LasDesu/Aleste-520EX/README.md

# aleste520ex
Project to recreate home computer Aleste 520EX
