LasDesu/Aleste-520EX/doc/manual.txt

                            ВВЕДЕНИЕ
      Поздравляем  Вас  с  покупкой  персонального  компьютера
" ALESTE 520  EX ".   Эта   модель   компьютера   совместима  по
програмному    обеспечению   и   переферийному   оборудованию  с
компьютером  " AMSTRAD CPC 6128 ".
        Ниже  приведены  особенности  компьютера  этой   модели.
     - Англо / Русская клавиатура.
     - Энергонезависимое ЗУ с часами.
     - Возможность работы в CP/M или MSX-DOS.
     - Встроенный BASIC.
     - ОЗУ компьютера расширено до 512К.
     - Компьютер  поддерживает  5  графических  режимов  экрана.
     - В  качестве   монитора   возможно   применение   бытового
       телевизора.
     - Имеется возможность для подключения  принтера, джойстика,
       любого  устройства с интерфейсом RS-232 ( "мышь" и др. ).
        Данное  руководство  представляет необходимую информацию
для  правильного  включения  и эксплуатации компьютера.  Поэтому
внимательно прочтите это руководство перед вводом в эксплуатацию
компьютера  и  сохраните  его  в  надежном  месте,   так как оно
одновременно является паспортом Вашего компьютера.

            ТЕХНИЧЕСКИЕ ХАРАКТЕРИСТИКИ
 
Центральный процессор____________________________Z80A
Тактовая частота________________________________4 МГц
Память
      ОЗУ_____________________________________512 К
        ПЗУ______________________________________64 К
Клавиатура_____________________встроенная (78 клавиш)
                Графические режимы.
   160x200 16 цветов каждая точка из палитры 64 цвета
   20 знаков в строке, 25 строк
 
   320x200  4 цвета  каждая точка из палитры 64 цвета
   40 знаков в строке, 25 строк
 
   640x200 монохром  каждая точка из палитры 64 цвета
   80 знаков в строке, 25 строк
 
   320x200 16 цветов каждая точка из палитры 64 цвета
   40 знаков в строке, 25 строк
 
   640x200  4 цвета  каждая точка из палитры 64 цвета
   80 знаков в строке, 25 строк
 
В режиме AMSTRAD количество цветов в палитре уменьшается
до 27.   Два последних режима имеются только в  MSX-DOS.
 
Звук____________________________ стерео сопровождение
Часы с календарем___________________энергонезависимые
Внешнее запоминающее устройство______________Дисковод
      Колличество__________________________до 2 шт.
        Емкость
                MSX-DOS__________________________720К
                AMSTRAD BASIC____________________180К
        Тип______________________________5'25 или 3'5
Периферийные устройства
  - Джойстик
  - Принтер (последовательный или паралельный)
  - "Мышь" или любое устройство с интерфейсом RS-232
  - Усилитель (музыкальное сопровождение)
  - Др. устройства через системный разъем  (например,
    плату MAGIG SOUND - музыкальный синтезатор)
Общие данные
      Напряжение питания__________________220В 50Гц
        Размеры
        Основной блок_______________430х250х50 мм.мм.
        Блок питания________________80х190х120 мм.мм.
        Масса
        Основной блок__________________________1,5 кг
        Блок питания___________________________1,5 кг

                   КОМПЛЕКТАЦИЯ
Системный блок_________________________________1 шт.
Блок питания с дисководом______________________1 шт.
Диски__________________________________________5 шт.
Паспорт________________________________________1 шт.
Джойстик_______________________________________1 шт.
Кабель подключения к монитору__________________1 шт.

ВНИМАНИЕ! В компьютере может быть не установлена батарея
энергонезависимых часов.
 
                         МЕРЫ ПРЕДОСТАРОЖНОСТИ
     Хотя рассматриваемый компьютер сконструирован прочно, он не
должен подвергаться экстремальным условиям. Мы  рекомендуем  Вам
соблюдать  следующие  меры  предосторожности  для  того,   чтобы
обеспечить его долговечность.
     - Избегайте падений компьютера и ударов по нему.
     - Не  подвергайте  компьютер  действию  прямого  солнечного
       света  или  других  источников   тепла;   не   закрывайте
       вентиляционные отверстия.
     - Не проливайте жидкости; если жидкость пролита на основную
       плату или клавиатуру,  то немедленно выключите компьютер.
     - Избегайте  влажности и пыли  в  помещении,  где находится
       компьютер.
     - Не ставьте тяжелые предметы на клавиатуру.
     - Протирайте компьютер мягкой, чистой тканью, не применяйте
       растворителей или очистителей.

               ВВОД КОМПЬЮТЕРА В ЭКСПЛУАТАЦИЮ
     Распакуйте компоненты:
     - Компьютер
     - Блок питания с дисководом
     - Шнур для подключения монитора
     - Дискеты
ВНИМАНИЕ!   ПОДСОЕДИНЕНИЕ ВСЕХ РАЗъЕМОВ ОСУЩЕСТВЛЯЙТЕ ТОЛЬКО ПРИ
ОТКЛЮЧЕННОМ КОМПЬЮТЕРЕ.
 
                     СХЕМА ПОДКЛЮЧЕНИЯ
    Монитор
 ┌─────────┬──┐            Принтер         Дисковод с БП
 │         │оо│  Джойстик ┌────────┐           ┌─┬─┐
 │         │  │    ┌┐    ┌│╝╝╝╝╝╝╝╝│┐          │││о│
 │         │  │   ┌┼┼┐  ┌┤└────────┘├┐         │╕│ │
 │         │  │  ┌┴──┴┐ └──│─────────┘ ┌────────││ ──────┐
 └─────────┴│─┘  └│───┘    │      ┌────┘       └─┴─┘     │
    ┌───────┘     │        │      │   Усилитель     Мышь │
    │   ┌─────────┘        │      │ ┌────────────┐  ┌╦╦┐ │
    │   │   ┌──────────────┘      │ │   о о  О  о│  │  │ │
    │   │   │                     │ └─────────│──┘  └─│┘ │
    │   │   ├───┐      системный  └─────────┐ └────┐  │  │
   ┌┴┐ ┌┴┐ ┌┴┐ ┌┴┐  ┌── разъем ───┐       ┌─┴───┐ ┌┴┐┌┴┐┌┤
 ┌─┴1┴─┴2┴─┴3┴─┴4┴──────── 5 ─────────────── 6 ───┴7┴┴8┴┴9┐
 │                                                        │
 │                                                        │
 │                      К О М П Ь Ю Т Е Р                 │
 │                                                        │
 │                                                        │
 └────────────────────────────────────────────────────────┘
    1  -  разъем для подключения монитора
    2  -  разъем для подключения джойстика
    3  -  разъем 1 для подключения принтера
    4  -  разъем 2 для подключения принтера
    5  -  системный разъем
    6  -  разъем для подключения дисководов
    7  -  разъем для подключения усилителя
          ( для звукового сопровождения программ )
    8  -  разъем интерфейса RS-232 (подключается мышь или другие
          устройства с этим интерфейсом)
    9  -  шнур для подключения питания

                         ЗАПУСК КОМПЬЮТЕРА
 
     ПРИ ПЕРВОМ ВКЛЮЧЕНИИ КОМПЬЮТЕРА РЕКОМЕНДУЕМ ВАМ  ПРОИЗВЕСТИ
СЛЕДУЮЩИЕ ДЕЙСТВИЯ:
     -  УСТАНОВИТЬ  КОНФИГУРАЦИЮ  КОМПЬЮТЕРА  СОГЛАСНО   РАЗДЕЛУ
" КОНФИГУРАЦИЯ КОМПЬЮТЕРА ".
     - ЗАГРУЗИТЬ ОПЕРАЦИОННУЮ СИСТЕМУ СОГЛАСНО РАЗДЕЛУ  " ЗАПУСК
MSX-DOS ".
     - СДЕЛАТЬ КОПИИ СИСТЕМНЫХ ДИСКЕТ И РАБОТАТЬ В ДАЛЬНЕЙШЕМ  С
КОПИЯМИ (см. руководство к MSX-DOS).
  
     1)  Убедитесь,  что  компьютер  и  периферийные  устройства
подключены  к  электросети.
     2) Включать компьютерную  систему  необходимо  в  следующем
порядке:
        Монитор -- Периферийные устойства -- Компьютер
Выключать в обратном порядке.
     После включения питания на экране  появится  заставка  и  в
нижней части экрана сообщение:
                   BOOT ERROR. PRESS ANY KEY
     Сообщение BOOT  ERROR.  PRESS  ANY  KEY  (Ошибка  загрузки.
Нажмите любую клавишу), показывает Вам, что  компьютер попытался
загрузить операционную систему, но не нашел ее.
     В ответ на это сообщение  Вы  можете  произвести  следующие
действия:
     1) Вставить в  дисковод  диск  с  операционной  системой  и
нажать любую клавишу. Далее смотри раздел РАБОТА В MSX-DOS.
     2) Выйти в BASIC (см. раздел ЗАПУСК BASICа).
                          ПРИМЕЧАНИЕ
     - Если в момент включения в дисководе уже  была  дискета  с
операционной  системой,  то  система  загрузится  автоматически.
Сообщение BOOT ERROR. PRESS ANY KEY не выводится.
     - Для работы с BASIC  Вы  можете  нажать  клавишу  SHIFT  и
включить компьютер.  В этом случае заставка не будет выведена на
экран.  Она появится  когда Вы  первый раз попытаетесь загрузить
операционную систему командой  │MSX  или перезагрузите компьютер
без удержания клавиши SHIFT.

                      КОНФИГУРАЦИЯ КОМПЬЮТЕРА
 
     После включения в энергонезависимой памяти  устанавливается
конфигурация компьютера, т.е параметры определяющие,  как  будет
работать компьютер после включения.
     Для  просмотра  установленной конфигурации или ее изменения
необходимо   произвести  перезагрузку  компьютера  с  удержанием
клавиши  СТР,  т.е.  нажать  клавишу  СТР и  удерживая ее нажать
клавишу RES.
     После этого на экране появиться следующая таблица.
    
                      ALESTE 520EX  SETUP
       ┌──────────────────────────────────────────────┐
       │ Language                             English │
       │ Current date                      14/10/1993 │
       │ Current time                         0:00:04 │
       │ Boot drive                                А: │
       │ RAM disk                                 Off │
       │ Display type                           Color │
       │ Screen mode                        640x200x2 │
       │ Screen color    Text             Back        │
       │ Keyboard rate   Delay  08        Repeat   02 │
       │ Keyboard click                            On │
       │ Beep            Tone    0        Volume   08 │
       │ Mouse                                    Off │
       │ Print interface                     Parallel │
       │ Print coding                           KOI-8 │
       │ Serial port   RTS/CTS       Baud rate   1200 │
       │ Bits  8      Parity   Off      Stop bits   1 │
       ├──────────────────────────────────────────────┤
       │ ESC - Quit                                   │
       │ F1  - Save settings  and quit                │
       │ F5  - Run diagnostics                        │
       │           - Move cursor                      │
       │ SHIFT+   or SPASE - Charge field             │
       └──────────────────────────────────────────────┘
Если  Вы  хотите читать текст в таблице по русски - не перемещая
курсор нажмите клавишу пробел.
 
     При  первом  включении  Вам  необходимо  в  первую  очередь
установить точные ДАТУ и ВРЕМЯ.
 
                           Внимание!
     - Если при  включении  устанавливается  дата  14/10/1993  в
компьютере отсутствует батарейка или она неисправна.
     -  Если  в  компьютере  не  установлены  элементы  питания,
установленная конфигурация не будет запоминаться при  выключении
компьютера.  Поэтому  при последующем включении компьютера будет
восстанавливаться стандартная конфигурация, показанная в таблице.
     - Функция  Run diagnostics работает не на всех компьютерах.

                   ЗАПУСК BASIC-AMSTRAD
     Для выхода в режим BASIC-AMSTRAD необходимо нажать  клавишу
SCHIFT и удерживая ее нажать клавишу RESET. По сбросу на  экране
появиться следующие сообщения.
 
 ┌───────────────────────────────────────────┐
 │   Aleste 520EX Personal Computer          │
 │   @1985 Amstrad Consumer Electronics plc  │
 │             and Locomotive Software Ltd.  │
 │   Basic 1.1                               │
 │  Ready                                    │
 │  █                                        │
 │                                           │
 └───────────────────────────────────────────┘
 
Сообщение  Ready и курсор под ним показывает  Вам  что компьютер
готова к работе.
Некоторые команды работы с диском:
     CAT - Просмотра каталога.
     RUN"имя программы" - запуск программы.
     │CPM - запуск программ с защитой.
     Например: RUN"Exolon" <RETURN>.
Символ "│" вводится нажатием клавиши @ при нажатой клавише SHIFT.
 
ПРИМЕЧАНИЕ:  Форматы  дисков  операционной  системы  MSX-DOS   и
BASIC несовместимы.   Это oзначaeт что нельзя работать в BASIC с
дисками отформатированными в MSX-DOS и наоборот.  Если Вы хотите
сохранить  свою  программу  на  BASIC  на  диске Вам нужно будет
отформатировать  его   специальной   программой.    На  диске  с
системными программами MSX-DOS имеется такая программа (AMC.COM).

                         ЗАПУСК MSX-DOS
     Загрузить операционную систему можно  в  нескольких режимах
работы: ПК  ALESTE  520  EX  имеет  следующие  режимы  работы  в
операционной  системе  MSX-DOS,  которые   устанавливаются   при
инициализации.
     -  СТАНДАРТНЫЙ  РЕЖИМ  -  устанавливается   по   умолчанию.
Поддерживается работа с дисководами  A:  и  B:  (при  отсутствии
дисковода  B:   поддерживаются   логические   диски   на   одном
дисководе), конфигурация электронного диска  читается  из  часов
реального времени.  При  наличии  на  электронном  диске  файлов
операционной сиситемы с него производится начальная загрузка,  в
противном   случае   загрузка    производится    с    дисковода,
определенного в SETUP.
     - РЕЖИМ ОДНОГО ДИСКОВОДА - включается при удержании клавиши
CTRL после  сброса.  В  этом  режиме  используется  только  один
физический дисковод A: (независимо от наличия второго). При этом
несколько  увеличивается  объем  памяти,  доступной   программам
пользователя. Инициализация электронного диска и логика загрузки
ОС не отличается от стандартного режима.
     - РЕЖИМ ЗАГРУЗКИ С ДИСКОВОДА  -  включается  при  удержании
клавиши   ALT   после   сброса.   Режим   полностью   аналогичен
стандартному, за исключением того, что загрузка ОС  производится
с диска, определенного  в  SETUP.  Режим  полезен  для  спасения
файлов с электронного диска в случае, если загрузка  с  него  по
каким-либо причинам не производится.
     - РЕЖИМ  АВАРИЙНОЙ  ЗАГРУЗКИ  -  включается  при  удержании
клавиши ESC после сброса и используется в  случае  неисправности
часов реального  времени.  При  этом  загрузка  ОС  производится
всегда с дисковода A: и электронный диск не инициализируется.
     ПРИМЕЧАНИЕ:  Удержание  клавиши  ESC   приводит   также   к
включению режима авариной загрузки в BIOS и ПЗУ загрузчика.
     - РЕЖИМ АВАРИЙНОЙ ЗАГРУЗКИ  С  ИНИЦИАЛИЗАЦИЕЙ  ЭЛЕКТРОННОГО
ДИСКА - включается  при  удержании  комбинации  клавиш  ALT+ESC.
Отличается от предыдущего тем, что инициализируется  электронный
диск емкостью 256K независимо от установок в SETUP.
     При   необходимости   допускается   совместное    включение
нескольких режимов.
ВНИМАНИЕ! Если операционная система не загружается,  попытайтесь
загрузить ее, удерживая клавишу ESC.
 
     Для выхода в режим MSX-DOS необходимо:
     - вставить дискету с системой MSX-DOS в дисковод
     - в зависимости  от  выбраного  Вам  режима  работы  нажать
необходимую комбинацию клавиш и перезагрузить компьютер.
   После  загрузки  системы  на   экране   появиться   следующие
сообщения.
 
 ┌───────────────────────────────────────────┐
 │                                           │
 │   ALESTE 520EX BIOS version 1.01          │
 │   (c) 1993 PATISONIC                      │
 │                                           │
 │   MSX-DOS version 1.04                    │
 │   Copyright 1984 by Microsoft             │
 │                                           │
 │   Command version 2.2A                    │
 │   (c) 1993 Patisonic                      │
 │   Date is                                 │
 │                                           │
 │   a>_                                     │
 │                                           │
 └───────────────────────────────────────────┘
 
     Сообщение "a>" показывает о готовности системы к выполнению
Ваших команд.
     Операционную  систему  можно загрузить и из  AMSTRAD BASIC.
Для этого  после  выхода в  AMSTRAD BASIC  необходимо  выполнить
команду: │MSX <RETURN>.
 
     Некоторые команды работы с диском:
     DIR - Просмотра каталога.
     "имя программы" - загрузка программы.
     Например: a> PW <RETURN> - запускается текстовый редактор.
 
     Описание  системных  программ,  поставляемых  на диске,  Вы
можете приобрести в фирме PATISONIC.

                      НЕСИМВОЛЬНЫЕ КЛАВИШИ
 
                           BASIC
     ESC          Выполняет функцию прерывания программы.
 
     TAB          Переводит курсор вправо на позицию кратную  8.
 
     CTRL         В  сочетании  с  другими клавишами задает коды
                  управления или выводит символы  псевдографики.
 
     SHIFT        Эта  клавиша  нажимается одновременно с любыми
                  клавишами для получения большой буквы, а также
                  для    премещения    второго    курсора    при
                  редактировании.
 
    F1-F10        Функциональные    клавиши.     Это     клавиши
                  программируемых  функций.   Они действуют  так
                  как будут определены пользователем.
 
    DEL           Клавиша  удаления.   При нажатии этой клавиши,
                  символ стоящий, справа от курсора   удаляется,
                  а   все   остальные   символы   этой    строки
                  сдвигаются  влево  на  одну  позицию.
 
    BS            После нажатия этой клавиши удаляется 1  символ
                  слева  от  курсора,  курсор  и  все  остальные
                  символы строки сдвигаются влево.
 
    COPY          Позволяет  осуществлять  копирование.  Границы
                  копирования    задаются   с   помощью   клавиш
                  управления курсором ( см. описание BASIC ).
 
                  Курсор передвигается в направлении,  указанном
                  на  клавише.
 
    RETURN        При нажатии этой клавиши курсор  передвигается
                  в первую  позицию  следующей  строки  и  BASIC
                  начинает выполнение набранной команды.
 
    ENTER         Действует   аналогично   RETURN,    но   можно
                  перепрограммировать как функциональную клавишу.

                           MSX - DOS
     ESC          Используется в прикладных программах.
 
     TAB          Переводит курсор вправо на позицию кратную 8.
 
     CTRL         В  сочетании  с  другими клавишами задает коды
                  управления или выводит символы  псевдографики.
 
     SHIFT        Эта  клавиша  нажимается одновременно с любыми
                  клавишами для смены регистра.
 
     F1-F10       Используются в прикладных программах.
 
     DEL          Клавиша удаления символа.
 
     BS           После нажатия этой клавиши удаляется 1  символ
                  слева  от  курсора,  курсор  и  все  остальные
                  символы строки сдвигаются влево.
 
     HELP         Используется в прикладных программах.
 
     INS          Клавиша вставки.
 
     ALT          Используется в прикладных программах.
 
                  Курсор передвигается в направлении,  указанnом
                  на клавише.
 
     RETURN       При нажатии этой клавиши курсор  передвигается
                  в первую позицию следующей  строки  и  система
                  начинает выполнение набранной команды.
 
     ENTER        Действует аналогично RETURN.

                         СИМВОЛЬНЫЕ КЛАВИШИ
 
                                BASIC
                         НОРМАЛЬНЫЙ РЕЖИМ
┌─────┬─────┬─────┬─────┬─────┐               ┌─────┬─────┬─────┐    ┌─────┬─────┐
│     │     │     │     │     │               │     │     │ DEL │    │     │ RES │
└─────┴─────┴─────┴─────┴─────┘               └─────┴─────┴─────┘    └─────┴─────┘
┌─────┬───┬───┬───┬───┬───┬───┬───┬───┬───┬───┬───┬───┬───┬─────┐    ┌───┬───┬───┐
│ ESC │ ; │ 1 │ 2 │ 3 │ 4 │ 5 │ 6 │ 7 │ 8 │ 9 │ 0 │ - │   │  BS │    │   │   │   │
├─────┴─┬─┴─┬─┴─┬─┴─┬─┴─┬─┴─┬─┴─┬─┴─┬─┴─┬─┴─┬─┴─┬─┴─┬─┴─┬─┴─┬───┤    ├───┼───┼───┤
│  TAB  │ j │ c │ u │ k │ e │ n │ g │ { │ } │ z │ h │ : │ / │   │    │ F7│ F8│ F9│
├───────┴┬──┴┬──┴┬──┴┬──┴┬──┴┬──┴┬──┴┬──┴┬──┴┬──┴┬──┴┬──┴┬──┘   │    ├───┼───┼───┤
│  CTRL  │ f │ y │ w │ a │ p │ r │ o │ l │ d │ v │ \ │ . │RETURN│    │ F4│ F5│ F6│
├────┬───┴─┬─┴─┬─┴─┬─┴─┬─┴─┬─┴─┬─┴─┬─┴─┬─┴─┬─┴─┬─┴──┬┴──┬┴──┬───┤    ├───┼───┼───┤
│CAPS│SPARE│ q │ | │ s │ m │ i │ t │ x │ b │ @ │ '  │   │   │   │    │ F1│ F2│ F3│
├────┴───┬─┴───┼───┴───┴───┴───┴───┴───┴───┴┬──┴────┤   ├───┤   │    ├───┼───┼───┤
│  SHIFT │ COPY│         SPACE              │ SHIFT │   │   │   │    │ F0│ . │ENT│
└────────┴─────┴────────────────────────────┴───────┴───┴───┴───┘    └───┴───┴───┘
 
                    НОРМАЛЬНЫЙ РЕЖИМ + SHIFT
┌─────┬─────┬─────┬─────┬─────┐               ┌─────┬─────┬─────┐    ┌─────┬─────┐
│     │     │     │     │     │               │     │     │ DEL │    │     │ RES │
└─────┴─────┴─────┴─────┴─────┘               └─────┴─────┴─────┘    └─────┴─────┘
┌─────┬───┬───┬───┬───┬───┬───┬───┬───┬───┬───┬───┬───┬───┬─────┐    ┌───┬───┬───┐
│ ESC │ + │ ! │ " │ # │ $ │ % │ & │ ' │ ( │ ) │ _ │ = │   │  BS │    │   │   │   │
├─────┴─┬─┴─┬─┴─┬─┴─┬─┴─┬─┴─┬─┴─┬─┴─┬─┴─┬─┴─┬─┴─┬─┴─┬─┴─┬─┴─┬───┤    ├───┼───┼───┤
│ TAB   │ J │ C │ U │ K │ E │ N │ G │ [ │ ] │ Z │ H │ * │ ? │   │    │ F7│ F8│ F9│
├───────┴┬──┴┬──┴┬──┴┬──┴┬──┴┬──┴┬──┴┬──┴┬──┴┬──┴┬──┴┬──┴┬──┘   │    ├───┼───┼───┤
│  CTRL  │ F │ Y │ W │ A │ P │ R │ O │ L │ D │ V │ \ │ > │RETURN│    │ F4│ F5│ F6│
├────┬───┴─┬─┴─┬─┴─┬─┴─┬─┴─┬─┴─┬─┴─┬─┴─┬─┴─┬─┴─┬─┴──┬┴──┬┴──┬───┤    ├───┼───┼───┤
│CAPS│SPARE│ Q │ | │ S │ M │ I │ T │ X │ B │ │ │ <  │   │   │   │    │ F1│ F2│ F3│
├────┴───┬─┴───┼───┴───┴───┴───┴───┴───┴───┴┬──┴────┤   ├───┤   │    ├───┼───┼───┤
│  SHIFT │ COPY│         SPACE              │ SHIFT │   │   │   │    │ F0│ . │ENT│
└────────┴─────┴────────────────────────────┴───────┴───┴───┴───┘    └───┴───┴───┘
 
                         РЕЖИМ MSX-DOS
                       НОРМАЛЬНЫЙ  РЕЖИМ    
┌─────┬─────┬─────┬─────┬─────┐               ┌─────┬─────┬─────┐    ┌─────┬─────┐
│  F1 │  F2 │  F3 │  F4 │  F5 │               │ HELP│ INS │ DEL │    │     │ RES │
└─────┴─────┴─────┴─────┴─────┘               └─────┴─────┴─────┘    └─────┴─────┘
┌─────┬───┬───┬───┬───┬───┬───┬───┬───┬───┬───┬───┬───┬───┬─────┐    ┌───┬───┬───┐
│ ESC │ ; │ 1 │ 2 │ 3 │ 4 │ 5 │ 6 │ 7 │ 8 │ 9 │ 0 │ - │ _ │  BS │    │   │   │   │
├─────┴─┬─┴─┬─┴─┬─┴─┬─┴─┬─┴─┬─┴─┬─┴─┬─┴─┬─┴─┬─┴─┬─┴─┬─┴─┬─┴─┬───┤    ├───┼───┼───┤
│ TAB   │ j │ c │ u │ k │ e │ n │ g │ { │ } │ z │ h │ : │ / │   │    │ 7 │ 8 │ 9 │
├───────┴┬──┴┬──┴┬──┴┬──┴┬──┴┬──┴┬──┴┬──┴┬──┴┬──┴┬──┴┬──┴┬──┘   │    ├───┼───┼───┤
│  CTRL  │ f │ y │ w │ a │ p │ r │ o │ l │ d │ v │ \ │ . │RETURN│    │ 4 │ 5 │ 6 │
├────┬───┴─┬─┴─┬─┴─┬─┴─┬─┴─┬─┴─┬─┴─┬─┴─┬─┴─┬─┴─┬─┴──┬┴──┬┴──┬───┤    ├───┼───┼───┤
│CAPS│ R/L │ q │ ^ │ s │ m │ i │ t │ x │ b │ @ │ ,  │   │   │   │    │ 1 │ 2 │ 3 │
├────┴───┬─┴───┼───┴───┴───┴───┴───┴───┴───┴┬──┴────┤   ├───┤   │    ├───┼───┼───┤
│  SHIFT │ ALT │         SPACE              │ SHIFT │   │   │   │    │ 0 │ . │ENT│
└────────┴─────┴────────────────────────────┴───────┴───┴───┴───┘    └───┴───┴───┘
 
                   НОРМАЛЬНЫЙ РЕЖИМ + SHIFT
┌─────┬─────┬─────┬─────┬─────┐               ┌─────┬─────┬─────┐    ┌─────┬─────┐
│  F6 │  F7 │  F8 │  F9 │ F10 │               │ HELP│ INS │ DEL │    │     │ RES │
└─────┴─────┴─────┴─────┴─────┘               └─────┴─────┴─────┘    └─────┴─────┘
┌─────┬───┬───┬───┬───┬───┬───┬───┬───┬───┬───┬───┬───┬───┬─────┐    ┌───┬───┬───┐
│ ESC │ + │ ! │ " │ # │ $ │ % │ & │ ' │ ( │ ) │   │ = │ _ │  BS │    │   │   │   │
├─────┴─┬─┴─┬─┴─┬─┴─┬─┴─┬─┴─┬─┴─┬─┴─┬─┴─┬─┴─┬─┴─┬─┴─┬─┴─┬─┴─┬───┤    ├───┼───┼───┤
│ TAB   │ J │ C │ U │ K │ E │ N │ G │ [ │ ] │ Z │ H │ * │ ? │   │    │ 7 │ 8 │ 9 │
├───────┴┬──┴┬──┴┬──┴┬──┴┬──┴┬──┴┬──┴┬──┴┬──┴┬──┴┬──┴┬──┴┬──┘   │    ├───┼───┼───┤
│  CTRL  │ F │ Y │ W │ A │ P │ R │ O │ L │ D │ V │ | │ > │RETURN│    │ 4 │ 5 │ 6 │
├────┬───┴─┬─┴─┬─┴─┬─┴─┬─┴─┬─┴─┬─┴─┬─┴─┬─┴─┬─┴─┬─┴──┬┴──┬┴──┬───┤    ├───┼───┼───┤
│CAPS│ R/L │ Q │ ~ │ S │ M │ I │ T │ X │ B │ ` │ <  │   │   │   │    │ 1 │ 2 │ 3 │
├────┴───┬─┴───┼───┴───┴───┴───┴───┴───┴───┴┬──┴────┤   ├───┤   │    ├───┼───┼───┤
│  SHIFT │ ALT │         SPACE              │ SHIFT │   │   │   │    │ 0 │ . │ENT│
└────────┴─────┴────────────────────────────┴───────┴───┴───┴───┘    └───┴───┴───┘
 
                       РЕЖИМ РУССКИХ СИМВОЛОВ 
┌─────┬─────┬─────┬─────┬─────┐               ┌─────┬─────┬─────┐    ┌─────┬─────┐
│  F1 │  F2 │  F3 │  F4 │  F5 │               │ HELP│ INS │ DEL │    │     │ RES │
└─────┴─────┴─────┴─────┴─────┘               └─────┴─────┴─────┘    └─────┴─────┘
┌─────┬───┬───┬───┬───┬───┬───┬───┬───┬───┬───┬───┬───┬───┬─────┐    ┌───┬───┬───┐
│ ESC │ ; │ 1 │ 2 │ 3 │ 4 │ 5 │ 6 │ 7 │ 8 │ 9 │ 0 │ - │ ъ │  BS │    │   │   │   │
├─────┴─┬─┴─┬─┴─┬─┴─┬─┴─┬─┴─┬─┴─┬─┴─┬─┴─┬─┴─┬─┴─┬─┴─┬─┴─┬─┴─┬───┤    ├───┼───┼───┤
│ TAB   │ й │ ц │ у │ к │ е │ н │ г │ ш │ щ │ з │ х │ : │ / │   │    │ 7 │ 8 │ 9 │
├───────┴┬──┴┬──┴┬──┴┬──┴┬──┴┬──┴┬──┴┬──┴┬──┴┬──┴┬──┴┬──┴┬──┘   │    ├───┼───┼───┤
│  CTRL  │ ф │ ы │ в │ а │ п │ р │ о │ л │ д │ ж │ э │ . │RETURN│    │ 4 │ 5 │ 6 │
├────┬───┴─┬─┴─┬─┴─┬─┴─┬─┴─┬─┴─┬─┴─┬─┴─┬─┴─┬─┴─┬─┴──┬┴──┬┴──┬───┤    ├───┼───┼───┤
│CAPS│ R/L │ я │ ч │ с │ м │ и │ т │ ь │ б │ ю │ ,  │   │   │   │    │ 1 │ 2 │ 3 │
├────┴───┬─┴───┼───┴───┴───┴───┴───┴───┴───┴┬──┴────┤   ├───┤   │    ├───┼───┼───┤
│  SHIFT │ ALT │         SPACE              │ SHIFT │   │   │   │    │ 0 │ . │ENT│
└────────┴─────┴────────────────────────────┴───────┴───┴───┴───┘    └───┴───┴───┘
 
                 РЕЖИМ РУССКИХ СИМВОЛОВ + SHIFT
┌─────┬─────┬─────┬─────┬─────┐               ┌─────┬─────┬─────┐    ┌─────┬─────┐
│  F6 │  F7 │  F8 │  F9 │ F10 │               │ HELP│ INS │ DEL │    │     │ RES │
└─────┴─────┴─────┴─────┴─────┘               └─────┴─────┴─────┘    └─────┴─────┘
┌─────┬───┬───┬───┬───┬───┬───┬───┬───┬───┬───┬───┬───┬───┬─────┐    ┌───┬───┬───┐
│ ESC │ + │ ! │ " │ # │ $ │ % │ & │ ' │ ( │ ) │   │ = │ ъ │  BS │    │   │   │   │
├─────┴─┬─┴─┬─┴─┬─┴─┬─┴─┬─┴─┬─┴─┬─┴─┬─┴─┬─┴─┬─┴─┬─┴─┬─┴─┬─┴─┬───┤    ├───┼───┼───┤
│ TAB   │ Й │ Ц │ У │ К │ Е │ Н │ Г │ Ш │ Щ │ З │ Х │ * │ ? │   │    │ 7 │ 8 │ 9 │
├───────┴┬──┴┬──┴┬──┴┬──┴┬──┴┬──┴┬──┴┬──┴┬──┴┬──┴┬──┴┬──┴┬──┘   │    ├───┼───┼───┤
│  CTRL  │ Ф │ Ы │ В │ А │ П │ Р │ О │ Л │ Д │ Ж │ Э │ > │RETURN│    │ 4 │ 5 │ 6 │
├────┬───┴─┬─┴─┬─┴─┬─┴─┬─┴─┬─┴─┬─┴─┬─┴─┬─┴─┬─┴─┬─┴──┬┴──┬┴──┬───┤    ├───┼───┼───┤
│CAPS│ R/L │ Я │ Ч │ С │ М │ И │ Т │ Ь │ Б │ Ю │ <  │   │   │   │    │ 1 │ 2 │ 3 │
├────┴───┬─┴───┼───┴───┴───┴───┴───┴───┴───┴┬──┴────┤   ├───┤   │    ├───┼───┼───┤
│  SHIFT │ ALT │         SPACE              │ SHIFT │   │   │   │    │ 0 │ . │ENT│
└────────┴─────┴────────────────────────────┴───────┴───┴───┴───┘    └───┴───┴───┘
 
             ЦОКОЛЕВКА РАЗъЕМОВ
┌────────┬───────────┬───────────────┬────────────────────────┐
│ НОМЕР  │ОБОЗНАЧЕНИЕ│   ЗНАЧЕНИЕ    │        В И Д Е О       │
│КОНТАКТА│  СИГНАЛА  │   СИГНАЛА     │                        │
├────────┼───────────┼───────────────┼────────────────────────┤
│   1    │   SYNC    │ СИНХРОНИЗАЦИЯ │                        │
├────────┼───────────┼───────────────┤                        │
│   2    │    GND    │    ОБЩИЙ      │       ┌──┐  ┌──┐       │
├────────┼───────────┼───────────────┤    ┌─┘   └──┘   └─┐    │
│   3    │     R     │ КРАСНЫЙ  ЦВЕТ │   ┌    7      6    ┐   │
├────────┼───────────┼───────────────┤  ┌                  ┐  │
│   4    │     B     │ СИНИЙ  ЦВЕТ   │ │    3          1    │ │
├────────┼───────────┼───────────────┤  └                  ┘  │
│   5    │     G     │ ЗЕЛЕНЫЙ  ЦВЕТ │   └    5      4    ┘   │
├────────┼───────────┼───────────────┤    └─┐     2    ┌─┘    │
│   6    │   SOUND   │ ВЫХОД ЗВУКА   │       └────────┘       │
├────────┼───────────┼───────────────┤                        │
│   7    │    LUM    │ Ч/Б  СИГНАЛ   │                        │
├────────┼───────────┼───────────────┤                        │
│ КОРПУС │    GND    │    ОБЩИЙ      │                        │
└────────┴───────────┴───────────────┴────────────────────────┘
┌────────┬───────────┬───────────────┬────────────────────────┐
│ НОМЕР  │ОБОЗНАЧЕНИЕ│   ЗНАЧЕНИЕ    │     Д Ж О Й С Т И К    │
│КОНТАКТА│  СИГНАЛА  │   СИГНАЛА     │                        │
├────────┼───────────┼───────────────┼────────────────────────┤
│   1    │  COMMON   │ОБЩИЙ ДЖОЙСТИКА│                        │
├────────┼───────────┼───────────────┤                        │
│   2    │   LEFT    │    ВЛЕВО      │       ┌──┐  ┌──┐       │
├────────┼───────────┼───────────────┤    ┌─┘   └──┘   └─┐    │
│   3    │   RIGHT   │    ВПРАВО     │   ┌    7      6    ┐   │
├────────┼───────────┼───────────────┤  ┌                  ┐  │
│   4    │  FIRE 1   │   КНОПКА 1    │ │    3          1    │ │
├────────┼───────────┼───────────────┤  └                  ┘  │
│   5    │  FIRE 2   │   КНОПКА 2    │   └    5      4    ┘   │
├────────┼───────────┼───────────────┤    └─┐     2    ┌─┘    │
│   6    │   DOWN    │    ВНИЗ       │       └────────┘       │
├────────┼───────────┼───────────────┤                        │
│   7    │    UP     │    ВВЕРХ      │                        │
├────────┼───────────┼───────────────┤                        │
│ КОРПУС │    GND    │    ОБЩИЙ      │                        │
└────────┴───────────┴───────────────┴────────────────────────┘
┌────────┬───────────┬───────────────┬────────────────────────┐
│ НОМЕР  │ОБОЗНАЧЕНИЕ│   ЗНАЧЕНИЕ    │   У С И Л И Т Е Л Ь    │
│КОНТАКТА│  СИГНАЛА  │   СИГНАЛА     │                        │
├────────┼───────────┼───────────────┼────────────────────────┤
├────────┼───────────┼───────────────┤                        │
│   1    │    N/C    │               │       ┌──┐  ┌──┐       │
├────────┼───────────┼───────────────┤    ┌─┘   └──┘   └─┐    │
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
├────────┼───────────┼───────────────┤                        │
│   7    │    UCC    │     + 5В      │                        │
├────────┼───────────┼───────────────┤                        │
│ КОРПУС │    GND    │    ОБЩИЙ      │                        │
└────────┴───────────┴───────────────┴────────────────────────┘
─────────────────────────────────────────────────────────────────
                 К О М П Ь Ю Т Е Р (вид со стороны разъемов)
 
┌─────────────────────┐     ┌───────────────────────────────────┐
│ 17               1 A│     │ 31                             1 A│
│  =================  │     │  ===============================  │
│ 17               2 B│     │ 31                             1 B│
┴─────────────────────┴─────┴───────────────────────────────────┴
РАЗъЕМ ДЛЯ ПОДКЛЮЧЕНИЯ               СИСТЕМНЫЙ РАЗъЕМ
      ДИСКОВОДА
 
РАЗъЕМ ДЛЯ ПОДКЛЮЧЕНИЯ               СИСТЕМНЫЙ РАЗъЕМ
      ДИСКОВОДА                ┌─────┬────────┬┬─────┬──────────┐
                               │ А1  │ SOUND  ││ B1  │ GND      │
┌─────┬─────┬┬─────┬──────────┐├─────┼────────┤├─────┼──────────┤
│ A1  │ GND ││ B1  │ свободен ││ А2  │ A15    ││ B2  │ A14      │
├─────┼─────┤├─────┼──────────┤├─────┼────────┤├─────┼──────────┤
│ A2  │ GND ││ B2  │ свободен ││ А3  │ A13    ││ B3  │ A12      │
├─────┼─────┤├─────┼──────────┤├─────┼────────┤├─────┼──────────┤
│ A3  │ GND ││ B3  │ свободен ││ А4  │ A11    ││ B4  │ A10      │
├─────┼─────┤├─────┼──────────┤├─────┼────────┤├─────┼──────────┤
│ A4  │ GND ││ B4  │ -INDEX   ││ А5  │ A9     ││ B5  │ A8       │
├─────┼─────┤├─────┼──────────┤├─────┼────────┤├─────┼──────────┤
│ A5  │ GND ││ B5  │ -DRIVE0  ││ А6  │ A7     ││ B6  │ A6       │
├─────┼─────┤├─────┼──────────┤├─────┼────────┤├─────┼──────────┤
│ A6  │ GND ││ B6  │ -DRIVE1  ││ А7  │ A5     ││ B7  │ A4       │
├─────┼─────┤├─────┼──────────┤├─────┼────────┤├─────┼──────────┤
│ A7  │ GND ││ B7  │ свободен ││ А8  │ A3     ││ B8  │ A2       │
├─────┼─────┤├─────┼──────────┤├─────┼────────┤├─────┼──────────┤
│ A8  │ GND ││ B8  │ -MOTOR   ││ А9  │ A1     ││ B9  │ A0       │
├─────┼─────┤├─────┼──────────┤├─────┼────────┤├─────┼──────────┤
│ A9  │ GND ││ B9  │ -DIR     ││ А10 │ D7     ││ B10 │ D6       │
├─────┼─────┤├─────┼──────────┤├─────┼────────┤├─────┼──────────┤
│ A10 │ GND ││ B10 │ -STEP    ││ A11 │ D5     ││ B11 │ D4       │
├─────┼─────┤├─────┼──────────┤├─────┼────────┤├─────┼──────────┤
│ A11 │ GND ││ B11 │ -WRDATA  ││ А12 │ D3     ││ B12 │ D2       │
├─────┼─────┤├─────┼──────────┤├─────┼────────┤├─────┼──────────┤
│ A12 │ GND ││ B12 │ -GATE    ││ А13 │ D1     ││ B13 │ D0       │
├─────┼─────┤├─────┼──────────┤├─────┼────────┤├─────┼──────────┤
│ A13 │ GND ││ B13 │ -TRAC0   ││ А14 │ UCC    ││ B14 │ -MREQ    │
├─────┼─────┤├─────┼──────────┤├─────┼────────┤├─────┼──────────┤
│ A14 │ GND ││ B14 │ -WRTPRT  ││ А15 │ -M1    ││ B15 │ -RFSH    │
├─────┼─────┤├─────┼──────────┤├─────┼────────┤├─────┼──────────┤
│ A15 │ GND ││ B15 │ -RDATA   ││ А16 │ -IORQ  ││ B16 │ -RD      │
├─────┼─────┤├─────┼──────────┤├─────┼────────┤├─────┼──────────┤
│ A16 │ GND ││ B16 │ -SIDE    ││ А17 │ -WR    ││ B17 │ -HALT    │
├─────┼─────┤├─────┼──────────┤├─────┼────────┤├─────┼──────────┤
│ A17 │ GND ││ B17 │ свободен ││ А18 │ -INT   ││ B18 │ -NMI     │
└─────┴─────┴┴─────┴──────────┘├─────┼────────┤├─────┼──────────┤
 Знак "-" означает что         │ А19 │ -BUSRQ ││ B19 │ -BUSAK   │
 сигнал является активным      ├─────┼────────┤├─────┼──────────┤
 при низком уровне.            │ A20 │ -WAIT  ││ B20 │ свободен │
                               ├─────┼────────┤├─────┼──────────┤
                               │ А21 │ -RESET ││ B21 │ -ROMEN   │
                               ├─────┼────────┤├─────┼──────────┤
                               │ А22 │ ROMDIS ││ B22 │ -RAMEN   │
                               ├─────┼────────┤├─────┼──────────┤
                               │ А23 │ RAMDIS ││ B23 │ CURSOR   │
                               ├─────┼────────┤├─────┼──────────┤
                               │ А24 │ L. PEN ││ B24 │ -EXP     │
                               ├─────┼────────┤├─────┼──────────┤
                               │ А25 │ GND    ││ B25 │ CLK      │
                               ├─────┼────────┤├─────┼──────────┤
                               │ А26 │ MAP14  ││ B26 │ MAP15    │
                               ├─────┼────────┤├─────┼──────────┤
                               │ А27 │ MAP16  ││ B27 │ MAP17    │
                               ├─────┼────────┤├─────┼──────────┤
                               │ А28 │ MAP18  ││ B28 │ MAPBLK   │
                               ├─────┼────────┤├─────┼──────────┤
                               │ А29 │ -INTA  ││ B29 │ -DIS     │
                               ├─────┼────────┤├─────┼──────────┤
                               │ A30 │ GNDA   ││ B30 │  DIS     │
                               ├─────┼────────┤├─────┼──────────┤
                               │ А31 │ UCCA   ││B31  │  HIGHTZ  │
                               └─────┴────────┴┴─────┴──────────┘

               СВИДЕТЕЛЬСТВО О ПРИЕМКЕ И ПРОДАЖЕ
 
Персональный  компьютер  " ALESTE 520 EX "  выходной  контроль и
тестирование прошел.

     Штамп ОТК

     Дата выпуска "___"______________________ 199___ г.
 
     Заводской номер N°_______________________________
 
     Продан______________________________ Дата продажи
 
     Гарантийные обязательства:
     Изготовитель гарантирует работоспособность  компьютера  при
соблюдении  правил  хранения  и  эксплуатации  в  течение  шести
месяцев со дня продажи.
     Изготовитель  производит   безвозмездный   ремонт,   замену
компьютера и его составных частей в течении гарантийного  срока,
если выход из строя произошел по вине изготовителя.
 
     Претензии без отметки о продаже не принимаются.
 
     Со всеми вопросами обращаться по телефону:
                           23-67-48
     с 16.00 до 18.00 часов кроме субботы и воскресенья.
 
     Подключение компьютера к телевизору:
                           33-51-42
