LasDesu/Aleste-520EX/sch/aleste.kicad_pcb

## KiCad design sch/aleste.kicad_pcb (2016-05-15)

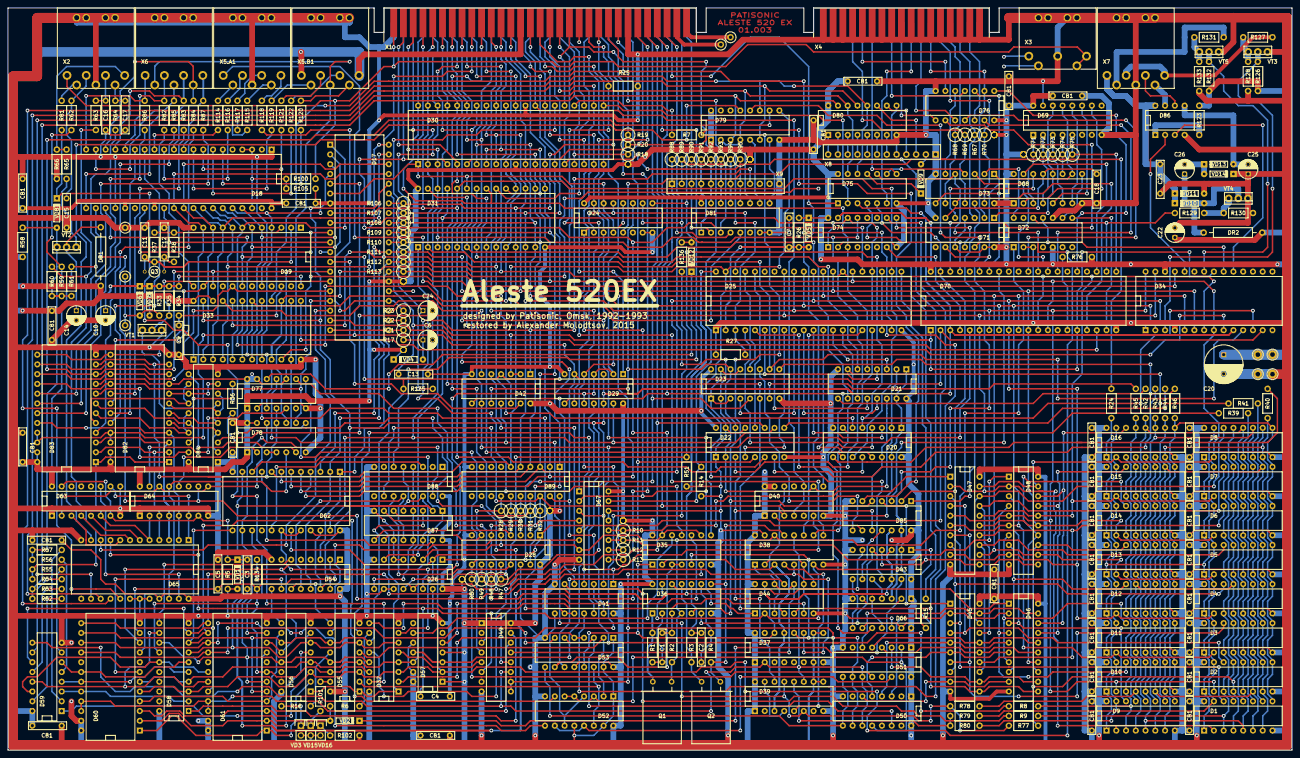
[picture p1: board aleste.kicad_pcb from above]

Board: 2 copper layers, 334.0 x 193.0 mm, 313 parts (0 on the bottom side), 453 nets.

Parts:
C1, C2, C3, C4, C5, C7, C9, C11, C12, C13, C15, C16, C17, C18, C23: CAP; C_Disc_D7.5_P2.5
C6, C10, C14, C22, C24, C25, C26: CAPP; C_Radial_D5_L6_P2.5
C20: CAPP; C_Radial_D10_L16_P5
CB1, CB1#2, CB1#3, CB1#4, CB1#5, CB1#6, CB1#7, CB1#8, CB1#9, CB1#10, CB1#11, CB1#12, CB1#13, CB1#14, CB1#15, CB1#16, CB1#17, CB1#18, CB1#19, CB1#20, CB1#21, CB1#22, CB1#23, CB1#24, CB1#25, CB1#26, CB1#27, CB1#28, CB1#29: CAP; C_Disc_D7.5_P2.5
D1, D2, D3, D4, D5, D6, D7, D8, D9, D10, D11, D12, D13, D14, D15, D16: 565РУ7; DIP-16
D17: 580ВВ55; DIP-40
D18: AY-3-8910; DIP-40
D19: 512ВИ1; DIP-24
D20, D21, D22, D23, D52, D53: 555КП2; DIP-16
D24, D81: 555КП7; DIP-16
D25: 1809ВГ6; DIP-40
D26: 555КП12; DIP-16
D28, D67: 556РТ4; DIP-16
D29, D44: 555ЛЛ1; DIP-14
D30: Z80; DIP-40
D31: 27512; DIP-28
D32, D55, D56, D59, D68, D79: 555ТМ9; DIP-16
D33: 580ВИ53; DIP-24
D34: 580ВВ51; DIP-28
D35, D85: 555ЛИ1; DIP-14
D36, D42, D73: 555ЛН1; DIP-14
D37: 555ИЕ10; DIP-16
D38: 555КП11; DIP-16
D39, D49, D50, D51: 555ИР11; DIP-16
D40, D57, D66, D71, D77: 555ТМ2; DIP-14
D41, D75, D78: 555ЛА3; DIP-14
D43: 555ЛЕ1; DIP-14
D45, D46, D47, D48: 555ИР22; DIP-20
D54, D74: 555ИД4; DIP-16
D58, D84: 555ИР23; DIP-20
D60, D61, D82, D83: 1802ИР1; DIP-24
D62, D65: 573РФ2; DIP-24
D63, D64: 561ИЕ10; DIP-16
D69: 155РЕ3; DIP-16
D70: 1810ВГ72; DIP-40
D72: 555ИЕ5; DIP-14
D76: 555ЛН2; DIP-14
D80: 555ИД10; DIP-16
D86: 170АП2; DIP-8
D87, D88: 555ИР32; DIP-16
D89: 555АП6; DIP-20
DR1, DR2: INDUCTOR; Choke_Horizontal_RM15mm
P1, P2, P3, P4, P5, P6, P7, P7#2, P8: PIN
Q1: 16 MHz; Crystal_HC49-U_Horizontal_Typ1
Q2: 13.333 MHz; Crystal_HC49-U_Horizontal_Typ1
Q3: QUARTZ; Crystal_Round_Vertical_5mm
R1, R2, R3, R4, R5, R6, R7, R8, R9, R14, R15, R16, R24, R25, R26, R27, R33, R34, R35, R36, R37, R38, R39, R40, R41, R42, R43, R44, R45, R46, R51, R52, R53, R54, R55, R56, R57, R58, R59, R60, R61, R62, R63, R64, R65, R66, R76, R77, R78, R79, R80, R81, R82, R83, R84, R85, R86, R87, R100, R101, R102, R105, R114, R115, R116, R117, R118, R119, R120, R121, R122, R123, R126, R127, R128, R129, R130, R131, R132, R133, R134, R135, R136: RES; Resistor_Horizontal_RM7.5mm
R10, R11, R12, R13, R17, R18, R19, R20, R21, R22, R23, R28, R29, R30, R31, R32, R47, R48, R49, R50, R67, R68, R69, R70, R71, R72, R73, R74, R75, R88, R89, R90, R91, R92, R93, R94, R95, R106, R107, R108, R109, R110, R111, R112, R113: RES; Resistor_Vertical_RM2.5mm
VD1, VD2, VD4, VD5, VD6, VD7, VD8, VD9, VD10, VD12, VD13, VD14: DIODE_MY; Diode_DO-35_SOD27_Horizontal_RM7.5
VD3, VD15, VD16: LED_MY; Pin_Header_Straight_1x02
VD11: ZDIODE_MY; Diode_DO-35_SOD27_Horizontal_RM7.5
VT1, VT2, VT3, VT4, VT5: NPN; KT315_KT361
X1: SLOT-62; SLOT_62
X2, X5.A1, X5.B1, X6, X7: CONN-7S; DNR-8F1R
X3: CONN-5S; DNR-5F1R
X4: SLOT-34
X8, X9: CONN-12; FB-12

Connections:
/AGND: P4.1, X1.A30
/AVCC: P3.1, X1.A31
/CPU/A0: D30.30, D31.10, D33.19, D41.2, D42.9, D67.3, D70.5, X1.B9
/CPU/A1: D20.6, D30.31, D31.9, D33.20, X1.A9
/CPU/A2: D20.10, D30.32, D31.8, X1.B8
/CPU/A3: D21.6, D30.33, D31.7, X1.A8
/CPU/A4: D21.10, D30.34, D31.6, X1.B7
/CPU/A5: D22.6, D30.35, D31.5, X1.A7
/CPU/A6: D23.6, D30.36, D31.4, D44.4, X1.B6
/CPU/A7: D21.11, D30.37, D31.3, D74.13, X1.A6
/CPU/A8: D17.9, D20.5, D25.24, D26.4, D30.38, D31.25, D34.12, D74.1, D74.14, X1.B5
/CPU/A9: D17.8, D20.11, D25.22, D26.12, D30.39, D31.24, X1.A5
/CPU/A10: D21.5, D30.40, D31.21, D74.3, X1.B4
/CPU/A11: D17.6, D24.4, D24.14, D30.1, D31.23, X1.A4
/CPU/A12: D23.10, D30.2, D31.2, D34.11, X1.B3
/CPU/A13: D22.10, D29.13, D30.3, D31.26, D62.23, X1.A3
/CPU/A14: D25.25, D26.3, D28.5, D30.4, D35.9, D35.13, D67.7, X1.B2
/CPU/A15: D26.13, D28.6, D30.5, D54.14, D62.22, D67.4, D89.1, X1.A2
/CPU/BUFFER0: D47.1, D67.12, R10.1
/CPU/BUFFER1: D48.1, D67.11, R11.1
/CPU/CLK: D30.6, D39.14, D40.3, R20.1, X1.B25
/CPU/D0: D1.2, D9.2, D17.34, D25.33, D30.14, D31.11, D34.27, D47.2, D48.2, D62.8, D70.6, D89.6, R106.1, X1.B13
/CPU/D1: D2.2, D10.2, D17.33, D25.32, D30.15, D31.12, D34.28, D47.5, D48.5, D62.7, D70.7, D89.5, R107.1, X1.A13
/CPU/D2: D3.2, D11.2, D17.32, D25.31, D30.12, D31.13, D34.1, D47.6, D48.6, D62.6, D70.8, D89.4, R108.1, X1.B12
/CPU/D3: D4.2, D12.2, D17.31, D25.30, D30.8, D31.15, D34.2, D47.9, D48.9, D62.5, D70.9, D89.3, R109.1, X1.A12
/CPU/D4: D5.2, D13.2, D17.30, D25.29, D30.7, D31.16, D34.5, D47.12, D48.12, D62.4, D70.10, D89.2, R110.1, X1.B11
/CPU/D5: D6.2, D14.2, D17.29, D25.28, D30.9, D31.17, D34.6, D47.15, D48.15, D62.3, D70.11, R111.1, X1.A11
/CPU/D6: D7.2, D15.2, D17.28, D25.27, D30.10, D31.18, D34.7, D47.16, D48.16, D54.13, D62.2, D70.12, R112.1, X1.B10
/CPU/D7: D8.2, D16.2, D17.27, D25.26, D30.13, D31.19, D34.8, D47.19, D48.19, D54.3, D62.1, D70.13, R113.1, X1.A10
/CPU/HY: C3.1, D25.40, D43.12, D85.12
/CPU/LOP: D43.10, D66.4
/CPU/PROM0: D55.7, D67.5
/CPU/PROM1: D55.10, D67.6
/CPU/RAMDIS: D67.15, R14.2, X1.A23
/CPU/ROM0: D35.10, D57.5
/CPU/ROM1: D35.12, D57.9
/CPU/ROMDIS: D31.22, R25.1, X1.A22
/CPU/SINT: D66.3, D79.12, D85.13
/CPU/~BUSAK: D30.23, X1.B19
/CPU/~BUSRQ: D30.25, R19.1, X1.A19
/CPU/~HALT: D30.18, X1.B17
/CPU/~INT: D30.16, R15.2, X1.A18
/CPU/~INTA: D29.8, D66.10, X1.A29
/CPU/~IORD: D17.5, D29.6, D34.13, D41.13, D70.2, D82.21, D82.22, D83.21, D83.22, D89.19
/CPU/~IORQ: D26.14, D29.2, D29.4, D29.10, D30.20, D62.18, D62.20, X1.A16
/CPU/~IOWR: D17.36, D29.3, D29.12, D33.23, D34.10, D41.12, D54.15, D70.3, D74.15
/CPU/~M1: D29.9, D30.27, X1.A15
/CPU/~MREQ: D30.19, D44.1, D67.2, X1.B14
/CPU/~NMI: D30.17, R18.1, X1.B18
/CPU/~RAMEN: D67.9, R13.1, X1.B22
/CPU/~RD: D29.5, D30.21, D67.1, D75.2, X1.B16
/CPU/~RESET: D18.23, D19.18, D32.1, D42.4, D55.1, D56.1, R135.1, X1.A21
/CPU/~RESET*: C24.1, D30.26, R135.2
/CPU/~RFSH: D30.28, D40.4, D40.10, X1.B15
/CPU/~ROMEN: D31.20, D67.10, R12.1, X1.B21
/CPU/~WAIT: D30.24, R7.2, X1.A20
/CPU/~WR: D29.1, D30.22, X1.A17
/Clocks & CRTC/1CY: D64.12, D78.2
/Clocks & CRTC/1M: D18.22, D37.11, D38.5, D64.10
/Clocks & CRTC/2CY: D64.13, D65.22, D78.5
/Clocks & CRTC/2M: D37.12, D38.2, D38.6, D44.9
/Clocks & CRTC/3CY: D63.2, D64.9, D64.14, D78.12
/Clocks & CRTC/4M: D35.2, D37.13, D38.3, D39.3
/Clocks & CRTC/8M: D35.1, D37.14, D44.13, D53.13
/Clocks & CRTC/13MHZ: D36.8, D38.13, Q2.1, R4.2
/Clocks & CRTC/16MHZ: D36.4, D38.14, D72.1, Q1.1, R2.2
/Clocks & CRTC/CAS: D39.12, R79.1, R80.1
/Clocks & CRTC/CBUF: D25.21, D43.4, D47.11, D48.11
/Clocks & CRTC/CURSOR: D25.19, D33.16, X1.B23
/Clocks & CRTC/DEN: D25.18, D77.12
/Clocks & CRTC/HIGHT: D38.1, D44.10, D44.12, D49.13
/Clocks & CRTC/HX: D25.39, D33.18, D43.11, D77.3, D79.9
/Clocks & CRTC/HY*: D17.18, D65.10
/Clocks & CRTC/KK0: D65.14, D79.3, D80.15
/Clocks & CRTC/KK1: D65.15, D75.13, D79.4, D80.14
/Clocks & CRTC/KK2: D65.16, D79.6, D80.13
/Clocks & CRTC/KK3: D65.17, D75.12, D79.11, D80.12
/Clocks & CRTC/L0: D24.2, D24.13, D25.38
/Clocks & CRTC/L1: D23.12, D25.37
/Clocks & CRTC/L2: D22.12, D25.36
/Clocks & CRTC/L.PEN: D25.3, R27.2, X1.A24
/Clocks & CRTC/MK0: D63.6, D64.2, D65.5, D82.1, D83.1
/Clocks & CRTC/MK1: D64.3, D65.4, D82.2, D83.2
/Clocks & CRTC/MK2: D64.4, D65.3, D82.3, D83.3
/Clocks & CRTC/MK3: D64.5, D65.2, D82.4, D83.4
/Clocks & CRTC/RAS: D39.6, D39.13, D42.11, D77.11, R77.1, R78.1
/Clocks & CRTC/SINT*: D65.11, D79.13
/Clocks & CRTC/SYNC*: C4.2, D49.6, D65.9
/Clocks & CRTC/V1: D20.4, D25.4
/Clocks & CRTC/V2: D20.12, D25.5
/Clocks & CRTC/V3: D21.4, D25.6
/Clocks & CRTC/V4: D21.12, D25.7
/Clocks & CRTC/V5: D22.4, D25.8
/Clocks & CRTC/V6: D23.4, D25.9
/Clocks & CRTC/V7: D21.13, D25.10
/Clocks & CRTC/V8: D20.3, D25.11
/Clocks & CRTC/V9: D20.13, D25.12
/Clocks & CRTC/V10: D21.3, D25.13
/Clocks & CRTC/V11: D25.14, D38.10
/Clocks & CRTC/V13: D25.16, D38.11
/Clocks & CRTC/V14: D22.3, D25.17
/Clocks & CRTC/V1113: D24.1, D24.12, D38.9
/Clocks & CRTC/VCLK: D36.13, D38.7, D43.2, D44.2, D45.1, D85.4
/Clocks & CRTC/XTAL: D37.2, D38.12, D39.11, D49.11, D50.11, D51.11, D59.9
/Clocks & CRTC/~3CY: D77.4, D78.11, D82.11, D83.11
/Clocks & CRTC/~RESET2: C7.2, D25.2, R26.1, VD5.2
/FDC/DISCINT: D17.19, D70.18
/FDC/DSKRDY: D70.35, D71.9, D76.3
/FDC/DW: D70.22, D72.12, R129.1
/FDC/EXRG: D44.5, D74.10
/FDC/FP0: D68.3, D69.1, R71.1
/FDC/FP1: D68.4, D69.2, R72.1
/FDC/FP2: D68.6, D69.3, R73.1
/FDC/FP3: D68.11, D69.4, R74.1
/FDC/RDD: D68.15, D70.23
/FDC/RESET: C13.2, D17.35, D34.21, D42.2, D42.3, D70.1, D70.16
/FDC/RSCLK: D34.20, D72.11
/FDC/RW/S: D70.39, D75.5, D85.2
/FDC/WGPTCLK: D33.9, D33.15, D70.19, D72.8
/FDC/WRC: D69.5, D70.21, R75.1
/FDC/XD0: D32.3, D55.3, D56.3, D57.2, D58.3, D60.5, D62.9, D71.12, D87.15
/FDC/~DIR: D76.8, X4.A9
/FDC/~DRIVE0: D76.6, X4.A5
/FDC/~DRIVE1: D75.8, X4.A6
/FDC/~GATE: D71.2, D76.2, X4.A12
/FDC/~INDEX: D73.11, R69.1, X4.A4
/FDC/~MOTOR: D76.4, X4.A8
/FDC/~RDATA: D71.3, R67.1, X4.A15
/FDC/~SIDE: D76.12, X4.A16
/FDC/~STEP: D75.6, X4.A10
/FDC/~TRAC0: D73.13, R70.1, X4.A13
/FDC/~WRDAT: D76.10, X4.A11
/FDC/~WRTPRT: D73.9, R68.1, X4.A14
/Gate Array/4ST: D35.3, D35.4, D53.10
/Gate Array/8ST: D44.11, D53.11
/Gate Array/"A": D26.7, D87.5, D87.14, D88.5, D88.14
/Gate Array/"B": D26.9, D87.4, D87.13, D88.4, D88.13
/Gate Array/B: C15.1, R62.1, X2.4
/Gate Array/BLAKS: D32.10, R6.2
/Gate Array/BLANK: D59.1, R6.1, VD2.2
/Gate Array/C0: D58.2, D59.3, D60.20
/Gate Array/C1: D58.5, D59.4, D60.19
/Gate Array/C2: D58.6, D59.6, D60.18
/Gate Array/C3: D58.9, D59.11, D61.20
/Gate Array/C4: D58.12, D59.13, D61.19
/Gate Array/C5: D58.15, D59.14, D61.18
/Gate Array/CBORDER: D54.6, D58.11
/Gate Array/COLOR: C5.2, D54.2, D60.11, D61.11, R134.1
/Gate Array/CS53: D32.12, D42.5
/Gate Array/G: C16.1, R63.1, X2.5
/Gate Array/HIGHTX: D32.5, D49.5
/Gate Array/HIGHTY: D32.2, R136.2
/Gate Array/HIGHTZ: D24.9, R136.1, VD12.2, X1.B31
/Gate Array/LED0: D55.12, R16.1
/Gate Array/LED1: D55.15, R101.1
/Gate Array/LUM: R65.2, R66.2, X2.7
/Gate Array/M0: D28.7, D87.10, D89.14, R28.1
/Gate Array/M1: D28.4, D87.9, D89.15, R29.1
/Gate Array/M2: D28.3, D87.7, D89.16, R30.1
/Gate Array/M3: D28.2, D87.6, D89.17, R31.1
/Gate Array/M4: D28.15, D85.10, D88.10, D89.18, R32.1, X1.A28
/Gate Array/MAP14: D24.3, D24.15, D28.12, R47.1, X1.A26
/Gate Array/MAP15: D22.5, D28.11, R48.1, X1.B26
/Gate Array/MAP16: D22.11, D28.10, R49.1, X1.A27
/Gate Array/MAP17: D23.5, D28.9, R50.1, X1.B27
/Gate Array/MAP18: D23.11, D85.8
/Gate Array/MAPBLK: D28.13, D88.11, R51.2, X1.B28
/Gate Array/MAPER: D54.12, D87.12, D88.12
/Gate Array/MAPMOD: D26.2, D28.1, D32.7, D62.19, D85.9
/Gate Array/MODE: D54.11, D55.9
/Gate Array/MODE0: D52.14, D53.14, D55.2
/Gate Array/MODE1: D52.2, D53.2, D55.5
/Gate Array/MVI: D35.6, D49.9, D49.10, D50.10, D51.10
/Gate Array/NCOLOR: D54.9, D56.9
/Gate Array/NCOLOR0: D56.2, D60.1, D61.1
/Gate Array/NCOLOR1: D56.5, D60.2, D61.2
/Gate Array/NCOLOR2: D56.7, D60.3, D61.3
/Gate Array/NCOLOR3: D56.10, D60.4, D61.4
/Gate Array/NCOLOR4: D54.1, D56.12, D60.10, D61.10
/Gate Array/PAGE: D49.15, D58.1
/Gate Array/PX0: D51.12, D60.13, D61.13
/Gate Array/PX1: D52.7, D60.14, D61.14
/Gate Array/PX2: D52.9, D60.15, D61.15
/Gate Array/PX3: D53.7, D60.16, D61.16
/Gate Array/R: C17.1, R64.1, X2.3
/Gate Array/RRC: D50.9, D51.9, D53.9
/Gate Array/SOUND: R100.2, X1.A1, X2.6, X3.3, X3.5
/Gate Array/SYNC: D49.12, R81.1, VD8.1
/Gate Array/VD0: D45.2, D46.2, D50.3
/Gate Array/VD1: D45.5, D46.5, D50.4
/Gate Array/VD2: D45.6, D46.6, D50.5
/Gate Array/VD3: D45.9, D46.9, D50.6
/Gate Array/VD4: D45.12, D46.12, D51.3
/Gate Array/VD5: D45.15, D46.15, D51.4
/Gate Array/VD6: D45.16, D46.16, D51.5
/Gate Array/VD7: D45.19, D46.19, D51.6
/Gate Array/VRAMACC: D62.17, D88.3
/Gate Array/XD1: D32.4, D55.4, D56.4, D57.12, D58.4, D60.6, D62.10, D87.1
/Gate Array/XD2: D32.6, D55.6, D56.6, D58.7, D60.7, D62.11, D87.2
/Gate Array/XD3: D32.11, D55.11, D56.11, D58.8, D61.5, D62.13, D87.3
/Gate Array/XD4: D32.13, D55.13, D56.13, D58.13, D61.6, D62.14, D88.15
/Gate Array/XD5: D32.14, D55.14, D58.14, D61.7, D62.15
/Gate Array/~CSAY: D32.15, R36.1
/Gate Array/~FUTURE: D41.8, D52.4, D52.11
/Gate Array/~PAGE: D49.14, D60.21, D60.22, D61.21, D61.22
/Periphery/50/60: D17.22, R22.1
/Periphery/+12V: C23.2, D86.8, VD10.1, VD11.1, X7.6
/Periphery/-12V: C25.2, D86.5, VD13.2
/Periphery/AY0: D17.4, D18.37, D19.4, D33.8
/Periphery/AY1: D17.3, D18.36, D19.5, D33.7
/Periphery/AY2: D17.2, D18.35, D19.6, D33.6
/Periphery/AY3: D17.1, D18.34, D19.7, D33.5
/Periphery/AY4: D17.40, D18.33, D19.8, D33.4
/Periphery/AY5: D17.39, D18.32, D19.9, D33.3
/Periphery/AY6: D17.38, D18.31, D19.10, D33.2
/Periphery/AY7: D17.37, D18.30, D19.11, D33.1
/Periphery/BC1: D17.11, D18.29
/Periphery/BDIR: D17.10, D18.27
/Periphery/BUSY: D17.24, R23.1, R118.1
/Periphery/COMMON: D78.8, X5.B1.2, X6.1
/Periphery/DSR: D34.22, R132.2, VT5.C
/Periphery/DSR*: R131.1, X7.1
/Periphery/DTR: D34.24, D86.2
/Periphery/DTR*: D86.7, X7.3
/Periphery/FUTURE: D33.17, D41.9, D41.10
/Periphery/KM0: D80.1, X8.12
/Periphery/KM1: D80.2, X8.11
/Periphery/KM2: D80.3, X8.10
/Periphery/KM3: D80.4, X8.9
/Periphery/KM4: D80.5, X8.8
/Periphery/KM5: D80.6, X8.7
/Periphery/KM6: D80.7, X8.6
/Periphery/KM7: D80.9, X8.5
/Periphery/KM8: D80.10, X8.4
/Periphery/KM9: D80.11, X8.3
/Periphery/KM10: VD9.2, X8.2
/Periphery/KM11: D81.4, R88.1, X9.1
/Periphery/KM12: D81.3, R89.1, X9.2
/Periphery/KM13: D81.2, R90.1, X9.3
/Periphery/KM14: D81.1, R91.1, X9.4
/Periphery/KM15: D81.15, R92.1, X9.5
/Periphery/KM16: D81.14, R93.1, X9.6
/Periphery/KM17: D81.13, R94.1, X9.7
/Periphery/KM18: D81.12, R95.1, X9.8
/Periphery/KRS: D81.5, D84.3
/Periphery/KW0: D79.2, D81.11
/Periphery/KW1: D79.5, D81.10
/Periphery/KW2: D79.7, D81.9
/Periphery/KW3: D79.10, D82.10, D83.10
/Periphery/PB2: D17.20, D17.21, R21.1
/Periphery/PD0: D18.13, R114.1
/Periphery/PD1: D18.12, R116.1
/Periphery/PD2: D18.11, R117.1
/Periphery/PD3: D18.10, R115.1
/Periphery/PD4: D18.9, R119.1
/Periphery/PD5: D18.8, R121.1
/Periphery/PD6: D18.7, R122.1
/Periphery/PD7: D18.6, R120.1
/Periphery/RXC: D33.10, D34.25
/Periphery/RXD: D34.3, R126.1, VT3.C
/Periphery/SABC: D18.3, D18.4, D18.38, R100.1, R105.2
/Periphery/SBRES: C6.1, D42.1, R17.1, VD4.2, X9.9
/Periphery/STROBE: D17.13, D42.13
/Periphery/TIN: D17.25, X3.1
/Periphery/TOUT: D17.12, X3.4
/Periphery/TXC: D33.13, D34.9
/Periphery/TXD: D34.19, D86.3
/Periphery/TXD*: D86.6, X7.5
/Periphery/VC1: C10.1, D19.24, R33.1, R34.2, R35.2, VD6.1, VD7.1
/Periphery/X1: D18.21, R87.2, X6.7
/Periphery/X2: D18.20, R86.2, X6.6
/Periphery/X3: D18.19, R85.2, X6.2
/Periphery/X4: D18.18, R84.2, X6.3
/Periphery/X5: D18.17, R83.2, X6.5
/Periphery/X6: D18.16, R82.2, X6.4
/Periphery/X7: D18.15, D82.19
/Periphery/X8: D18.14, D82.20
/Periphery/Y0: D17.14, D19.15, D78.10, D82.13, D83.13
/Periphery/Y1: D17.15, D19.14, D82.14, D83.14
/Periphery/Y2: D17.16, D19.17, D82.15, D83.15
/Periphery/Y3: D17.17, D78.9, D82.16, D83.16
/Periphery/Z0: D82.5, D84.2, D84.4
/Periphery/Z1: D82.6, D84.5, D84.7
/Periphery/Z2: D82.7, D84.6, D84.8
/Periphery/Z3: D82.8, D84.9, D84.13
/Periphery/Z4: D83.5, D84.12, D84.14
/Periphery/Z5: D83.6, D84.15, D84.17
/Periphery/Z6: D83.7, D84.16, D84.18
/Periphery/Z7: D83.8, D84.19
/Periphery/~CS53: D33.21, D42.6
/Periphery/~STROBE: D42.12, X5.A1.6
/RAM/CAS0: D1.15, D2.15, D3.15, D4.15, D5.15, D6.15, D7.15, D8.15, R79.2
/RAM/CAS1: D9.15, D10.15, D11.15, D12.15, D13.15, D14.15, D15.15, D16.15, R80.2
/RAM/DIS: D20.2, D21.2, D22.2, D23.2, D24.10, D40.9, X1.B30
/RAM/MA0: D1.5, D2.5, D3.5, D4.5, D5.5, D6.5, D7.5, D8.5, D9.5, D10.5, D11.5, D12.5, D13.5, D14.5, D15.5, D16.5, R39.2
/RAM/MA1: D1.7, D2.7, D3.7, D4.7, D5.7, D6.7, D7.7, D8.7, D9.7, D10.7, D11.7, D12.7, D13.7, D14.7, D15.7, D16.7, R40.2
/RAM/MA2: D1.6, D2.6, D3.6, D4.6, D5.6, D6.6, D7.6, D8.6, D9.6, D10.6, D11.6, D12.6, D13.6, D14.6, D15.6, D16.6, R41.2
/RAM/MA3: D1.12, D2.12, D3.12, D4.12, D5.12, D6.12, D7.12, D8.12, D9.12, D10.12, D11.12, D12.12, D13.12, D14.12, D15.12, D16.12, R42.2
/RAM/MA4: D1.11, D2.11, D3.11, D4.11, D5.11, D6.11, D7.11, D8.11, D9.11, D10.11, D11.11, D12.11, D13.11, D14.11, D15.11, D16.11, R43.2
/RAM/MA5: D1.10, D2.10, D3.10, D4.10, D5.10, D6.10, D7.10, D8.10, D9.10, D10.10, D11.10, D12.10, D13.10, D14.10, D15.10, D16.10, R44.2
/RAM/MA6: D1.13, D2.13, D3.13, D4.13, D5.13, D6.13, D7.13, D8.13, D9.13, D10.13, D11.13, D12.13, D13.13, D14.13, D15.13, D16.13, R45.2
/RAM/MA7: D1.9, D2.9, D3.9, D4.9, D5.9, D6.9, D7.9, D8.9, D9.9, D10.9, D11.9, D12.9, D13.9, D14.9, D15.9, D16.9, R46.2
/RAM/MA8: D1.1, D2.1, D3.1, D4.1, D5.1, D6.1, D7.1, D8.1, D9.1, D10.1, D11.1, D12.1, D13.1, D14.1, D15.1, D16.1, R24.2
/RAM/R0: D1.14, D45.3, D47.3
/RAM/R1: D2.14, D45.4, D47.4
/RAM/R2: D3.14, D45.7, D47.7
/RAM/R3: D4.14, D45.8, D47.8
/RAM/R4: D5.14, D45.13, D47.13
/RAM/R5: D6.14, D45.14, D47.14
/RAM/R6: D7.14, D45.17, D47.17
/RAM/R7: D8.14, D45.18, D47.18
/RAM/R8: D9.14, D46.3, D48.3
/RAM/R9: D10.14, D46.4, D48.4
/RAM/R10: D11.14, D46.7, D48.7
/RAM/R11: D12.14, D46.8, D48.8
/RAM/R12: D13.14, D46.13, D48.13
/RAM/R13: D14.14, D46.14, D48.14
/RAM/R14: D15.14, D46.17, D48.17
/RAM/R15: D16.14, D46.18, D48.18
/RAM/RAS0: D1.4, D2.4, D3.4, D4.4, D5.4, D6.4, D7.4, D8.4, R77.2
/RAM/RAS1: D9.4, D10.4, D11.4, D12.4, D13.4, D14.4, D15.4, D16.4, R78.2
/RAM/S0: D20.14, D21.14, D22.14, D23.14, D24.11, D36.5, D42.10, D85.5
/RAM/VBUF: D43.1, D45.11, D46.11
/RAM/WE0: D1.3, D2.3, D3.3, D4.3, D5.3, D6.3, D7.3, D8.3, R9.2
/RAM/WE1: D9.3, D10.3, D11.3, D12.3, D13.3, D14.3, D15.3, D16.3, R8.2
/RAM/~DIS: D40.8, D75.1, X1.B29
/RAM/~VCLK: D36.12, D43.6, D46.1
GND: C4.1, C5.1, C6.2, C7.1, C9.1, C10.2, C11.1, C12.1, C13.1, C14.2, C15.2, C16.2, C17.2, C18.1, C20.2, C22.2, C23.1, C24.2, C25.1, CB1.1, CB1#2.1, CB1#3.1, CB1#4.1, CB1#5.1, CB1#6.1, CB1#7.1, CB1#8.1, CB1#9.1, CB1#10.1, CB1#11.1, CB1#12.1, CB1#13.1, CB1#14.1, CB1#15.1, CB1#16.1, CB1#17.1, CB1#18.1, CB1#19.1, CB1#20.1, CB1#21.1, CB1#22.1, CB1#23.1, CB1#24.1, CB1#25.1, CB1#26.1, CB1#27.1, CB1#28.1, CB1#29.1, D1.16, D2.16, D3.16, D4.16, D5.16, D6.16, D7.16, D8.16, D9.16, D10.16, D11.16, D12.16, D13.16, D14.16, D15.16, D16.16, D17.7, D17.23, D18.1, D18.24, D19.12, D19.20, D20.1, D20.8, D20.15, D21.1, D21.8, D21.15, D22.1, D22.8, D22.13, D22.15, D23.1, D23.3, D23.8, D23.13, D23.15, D24.7, D24.8, D25.1, D26.1, D26.5, D26.6, D26.8, D26.10, D26.11, D26.15, D28.8, D28.14, D29.7, D30.29, D31.14, D32.8, D33.12, D34.4, D35.7, D36.7, D37.8, D38.8, D38.15, D39.8, D40.7, D41.7, D42.7, D43.7, D44.7, D45.10, D46.10, D47.10, D48.10, D49.8, D50.8, D51.8, D52.1, D52.8, D52.12, D52.15, D53.1, D53.4, D53.5, D53.8, D53.15, D54.8, D55.8, D56.8, D57.7, D58.10, D59.8, D60.12, D61.12, D62.12, D63.1, D63.8, D63.9, D64.1, D64.8, D65.12, D65.18, D65.19, D65.20, D66.7, D66.12, D67.8, D67.13, D67.14, D68.8, D69.8, D69.15, D70.20, D71.7, D72.2, D72.3, D72.10, D73.7, D74.2, D74.8, D75.7, D76.7, D77.2, D77.7, D78.7, D79.8, D80.8, D81.7, D81.8, D82.12, D83.12, D84.1, D84.10, D85.7, D86.4, D87.8, D87.11, D88.8, D89.10, P2.1, P6.1, P8.1, R5.1, R14.1, R25.2, R27.1, R51.1, R66.1, R102.1, R105.1, R128.1, R130.1, R133.1, VD1.2, VD11.2, VD14.1, VT1.E, VT3.E, VT4.E, VT5.E, X1.A25, X1.B1, X2.2, X2.S, X3.2, X3.S, X4.B1, X4.B2, X4.B3, X4.B4, X4.B5, X4.B6, X4.B7, X4.B8, X4.B9, X4.B10, X4.B11, X4.B12, X4.B13, X4.B14, X4.B15, X4.B16, X4.B17, X5.A1.2, X5.A1.S, X5.B1.S, X6.S, X7.2, X7.S, X8.1, X9.12
unnamed: C1.1, D36.2, R1.2
unnamed: C1.2, D36.3, R2.1
unnamed: C2.1, D36.10, R3.2
unnamed: C2.2, D36.9, R4.1
unnamed: C3.2, D63.7, D63.15, D64.7, R5.2, VD1.1
unnamed: C9.2, D19.22, R34.1
unnamed: C11.2, D19.2, Q3.2, R37.1
unnamed: C12.2, Q3.1, R38.1
unnamed: C14.1, DR1.2, VT2.C
unnamed: C18.2, D68.13, D71.6
unnamed: C26.1, DR2.2, VD10.2, VT4.C
unnamed: C26.2, VD13.1, VD14.2
unnamed: D19.3, R37.2, R38.2
unnamed: D19.13, R35.1, VT1.C
unnamed: D20.7, R39.1
unnamed: D20.9, R40.1
unnamed: D21.7, R41.1
unnamed: D21.9, R42.1
unnamed: D22.7, R43.1
unnamed: D22.9, R44.1
unnamed: D23.7, R45.1
unnamed: D23.9, R46.1
unnamed: D24.5, R24.1
unnamed: D25.23, D41.11
unnamed: D29.11, D57.3, D57.11
unnamed: D31.1, D35.11
unnamed: D31.27, D35.8
unnamed: D32.9, D44.6
unnamed: D35.5, D44.8
unnamed: D36.1, Q1.2, R1.1
unnamed: D36.6, D43.3, D43.5
unnamed: D36.11, Q2.2, R3.1
unnamed: D38.4, D39.5
unnamed: D39.4, D39.15
unnamed: D40.2, D75.3
unnamed: D40.6, D41.1, D41.4
unnamed: D40.12, D44.3
unnamed: D41.3, R8.1
unnamed: D41.5, D42.8
unnamed: D41.6, R9.1
unnamed: D43.8, D66.8
unnamed: D43.9, D85.11
unnamed: D43.13, VD2.1
unnamed: D49.3, D77.9
unnamed: D49.4, D77.8
unnamed: D50.12, D51.2, D52.3, D52.5, D52.6
unnamed: D50.14, D53.3, D53.6
unnamed: D51.14, D52.10, D52.13
unnamed: D54.10, R134.2
unnamed: D59.2, R57.2
unnamed: D59.5, R56.2
unnamed: D59.7, R55.2
unnamed: D59.10, R54.2
unnamed: D59.12, R53.2
unnamed: D59.15, R52.2
unnamed: D63.3, D65.8
unnamed: D63.4, D65.7
unnamed: D63.5, D65.6
unnamed: D63.10, D64.6, D65.1
unnamed: D63.11, D65.23
unnamed: D64.15, D77.5
unnamed: D66.2, D66.6
unnamed: D66.5, D66.11
unnamed: D66.9, D66.13, R15.1
unnamed: D68.2, D69.10
unnamed: D68.5, D69.11
unnamed: D68.7, D69.12
unnamed: D68.9, D72.9
unnamed: D68.10, D69.13, D73.1
unnamed: D68.12, D69.14, D71.1
unnamed: D68.14, D71.5
unnamed: D70.4, D74.7
unnamed: D70.15, R76.2
unnamed: D70.17, D73.10
unnamed: D70.25, D76.1
unnamed: D70.27, D76.13
unnamed: D70.28, D73.3
unnamed: D70.29, D73.5, D75.10
unnamed: D70.30, D76.11
unnamed: D70.33, D85.3
unnamed: D70.34, D73.8
unnamed: D70.37, D75.4
unnamed: D70.38, D76.9
unnamed: D71.11, D74.9
unnamed: D72.14, D73.2
unnamed: D73.4, D75.9
unnamed: D73.6, D76.5
unnamed: D73.12, D85.1
unnamed: D75.11, VD9.1
unnamed: D78.3, D78.4
unnamed: D78.6, D84.11
unnamed: D82.17, R83.1
unnamed: D82.18, R82.1
unnamed: D83.17, R87.1
unnamed: D83.18, R86.1
unnamed: D83.19, R85.1
unnamed: D83.20, R84.1
unnamed: D85.6, R7.1
unnamed: D86.1, R123.1
unnamed: D88.6, VD12.1
unnamed: P7.1, P7#2.1, R33.2, VD6.2
unnamed: R16.2, VD3.1
unnamed: R36.2, VT1.B
unnamed: R52.1, R53.1, R59.2, R62.2
unnamed: R54.1, R55.1, R60.2, R63.2
unnamed: R56.1, R57.1, R61.2, R64.2
unnamed: R58.1, R59.1, R60.1, R61.1, VD8.2, VT2.B
unnamed: R65.1, VT2.E
unnamed: R81.2, X2.1
unnamed: R101.2, VD15.1
unnamed: R102.2, VD16.1
unnamed: R114.2, X5.A1.1
unnamed: R115.2, X5.A1.3
unnamed: R116.2, X5.A1.4
unnamed: R117.2, X5.A1.5
unnamed: R118.2, X5.A1.7
unnamed: R119.2, X5.B1.1
unnamed: R120.2, X5.B1.3
unnamed: R121.2, X5.B1.4
unnamed: R122.2, X5.B1.5
unnamed: R127.1, R128.2, VT3.B
unnamed: R127.2, X7.4, X7.7
unnamed: R129.2, R130.2, VT4.B
unnamed: R131.2, R133.2, VT5.B
VCC: C20.1, C22.1, CB1.2, CB1#2.2, CB1#3.2, CB1#4.2, CB1#5.2, CB1#6.2, CB1#7.2, CB1#8.2, CB1#9.2, CB1#10.2, CB1#11.2, CB1#12.2, CB1#13.2, CB1#14.2, CB1#15.2, CB1#16.2, CB1#17.2, CB1#18.2, CB1#19.2, CB1#20.2, CB1#21.2, CB1#22.2, CB1#23.2, CB1#24.2, CB1#25.2, CB1#26.2, CB1#27.2, CB1#28.2, CB1#29.2, D1.8, D2.8, D3.8, D4.8, D5.8, D6.8, D7.8, D8.8, D9.8, D10.8, D11.8, D12.8, D13.8, D14.8, D15.8, D16.8, D17.26, D18.25, D18.28, D18.40, D20.16, D21.16, D22.16, D23.16, D24.16, D25.20, D26.16, D28.16, D29.14, D30.11, D31.28, D32.16, D33.11, D33.14, D33.22, D33.24, D34.26, D35.14, D36.14, D37.1, D37.7, D37.9, D37.10, D37.16, D38.16, D39.1, D39.9, D39.10, D39.16, D40.1, D40.13, D40.14, D41.14, D42.14, D43.14, D44.14, D45.20, D46.20, D47.20, D48.20, D49.1, D49.16, D50.1, D50.16, D51.1, D51.16, D52.16, D53.12, D53.16, D54.16, D55.16, D56.16, D57.1, D57.4, D57.10, D57.13, D57.14, D58.20, D59.16, D60.9, D60.23, D60.24, D61.9, D61.23, D61.24, D62.21, D62.24, D63.16, D64.16, D65.21, D65.24, D66.1, D66.14, D67.16, D68.1, D68.16, D69.16, D70.40, D71.4, D71.10, D71.13, D71.14, D72.5, D73.14, D74.16, D75.14, D76.14, D77.1, D77.10, D77.13, D77.14, D78.1, D78.13, D78.14, D79.1, D79.16, D80.16, D81.16, D82.9, D82.23, D82.24, D83.9, D83.23, D83.24, D84.20, D85.14, D87.16, D88.16, D89.20, DR1.1, DR2.1, P1.1, P5.1, R10.2, R11.2, R12.2, R13.2, R17.2, R18.2, R19.2, R20.2, R21.2, R22.2, R23.2, R26.2, R28.2, R29.2, R30.2, R31.2, R32.2, R47.2, R48.2, R49.2, R50.2, R58.2, R67.2, R68.2, R69.2, R70.2, R71.2, R72.2, R73.2, R74.2, R75.2, R76.1, R88.2, R89.2, R90.2, R91.2, R92.2, R93.2, R94.2, R95.2, R106.2, R107.2, R108.2, R109.2, R110.2, R111.2, R112.2, R113.2, R123.2, R126.2, R132.1, VD3.2, VD4.1, VD5.1, VD7.2, VD15.2, VD16.2, X1.A14, X5.B1.6, X5.B1.7
