LasDesu/Aleste-520EX/(commit log)

2016-05-15 Initial commit. Almost everything is done.
    [aleste.kicad_pcb, aleste.sch, clkcrtc.sch, cpu.sch, fdc.sch, gatearray.sch, periph.sch, ram.sch]
2016-05-15 Start to move to a bit more affordable components
    [aleste.sch, clkcrtc.sch, cpu.sch, fdc.sch, gatearray.sch, periph.sch, ram.sch]
2016-06-03 Update IR22 and IR23 symbols
    [gatearray.sch, ram.sch]
2016-06-27 GAL based PLL for FDC
    [fdc.sch, gatearray.sch]
2016-08-30 Another ROM replaced with PLD, source included
    [aleste.sch, clkcrtc.sch, cpu.sch, fdc.sch, gatearray.sch, periph.sch, ram.sch]
2016-08-31 Palette update for new schematic
2016-12-07 Fix MVI signal
    [aleste.sch, cpu.sch, gatearray.sch, ram.sch]
2017-01-03 Cosmetic schematic fix
    [gatearray.sch]
